XU32444/CIV102/README.md

# CIV102
This includes helpful resources for course CIV102
It has the design, schematic, and simulation result of our bridge.
