XU32444/CIV102/(list of files, cad)

Other CAD files:
CIV102/bridge project/FusionModel/Model/Model v3.f3d
CIV102/bridge project/FusionModel/Schematic/Sketch v5.f3d
