XU32444/CIV102/CIV102/bridge project/SimulationResult.png

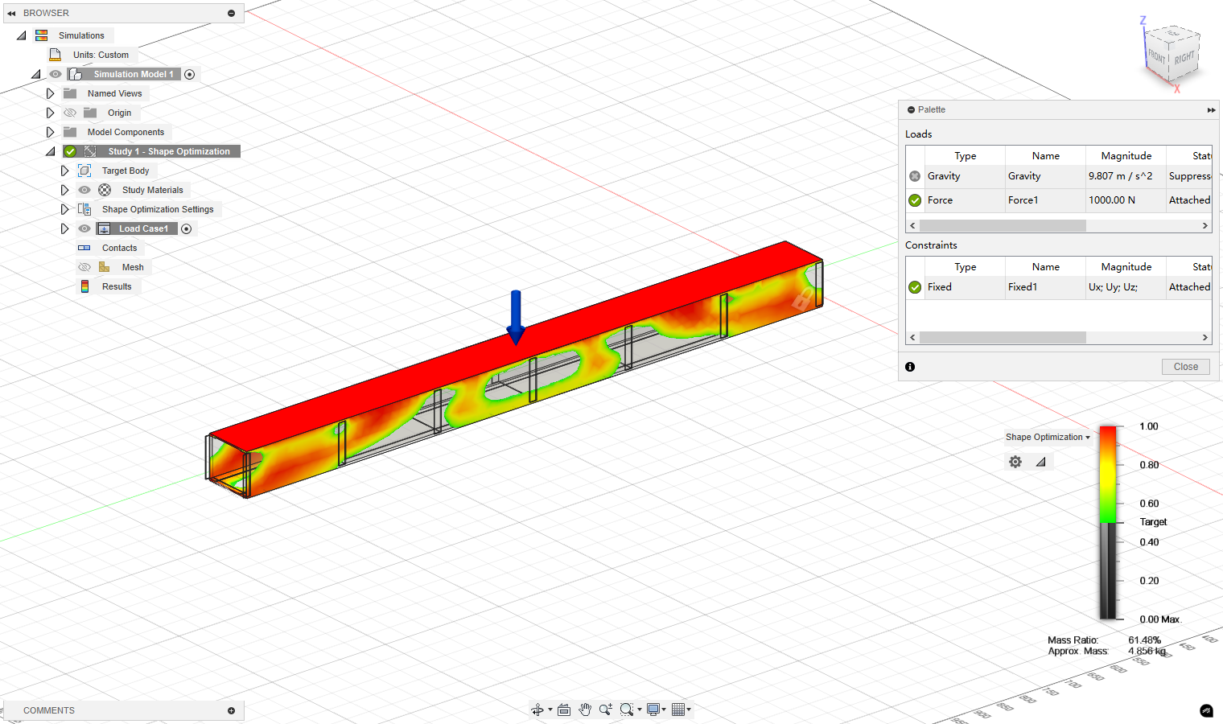
CIV102/bridge project/SimulationResult.png
